vespid-tech/orbweaver/README.md

# orbweaver

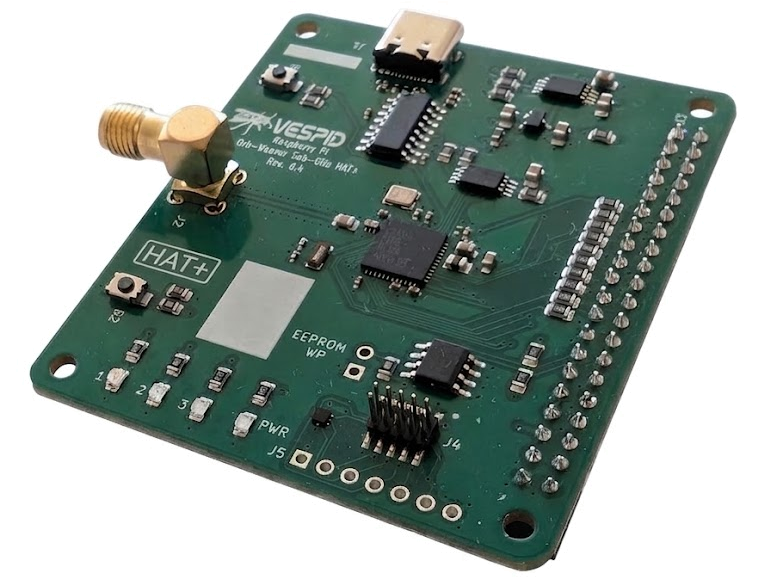
[picture p1: images/ow_pcb.png]


Orbweaver is a Sub-GHz HAT+ designed for the Raspberry Pi 5. When loaded with the Orbweaver firmware, it allows users to set-up peer-to-peer mesh networks between Raspberry Pi's, Desktop/Laptops, and Android mobile devices.

# Licensing & Trademarks

### Open Source Components
* **Hardware (`/hardware`)**: All hardware licensed under **CERN Open Hardware Licence Version 2 – Strongly Reciprocal** (`CERN-OHL-S-2.0`).
* **Firmware (`/firmware`)**: All firmware Licensed under the **GNU General Public License v3.0** (`GPL-3.0-only`).
* **Software (`/software`)**: All software Licensed under the **GNU General Public License v3.0** (`GPL-3.0-only`).
* **Documentation (`/documents`)**: All documentation (except the trademarks mentioned below) Licensed under the **Creative Commons Attribution-ShareAlike 4.0 International** (`CC BY-SA 4.0`).
* The full text of these licenses can be found in this repository in the hardware, software, and firmware folders they apply to.

### Non-open Source Components
* **Trademarks:** "Vespid," "Orbweaver," and associated logos are trademarks of Vespid.

# Questions, Info, Help

You can find out more about Vespid online at **[www.vespidtech.com](https://www.vespidtech.com)**.

# Disclaimer

Orbweaver is provided “as is,” without warranty of any kind express or implied. In no event shall Vespid or any Orbweaver developers or contributors be liable for any claim, damages, or other liability arising from its use. Orbweaver is intended for evaluation and development use only. It is not supplied as a finished product and is not certified for use in any product made for sale to the general public. The purchaser is responsible for ensuring that the final configuration (including but not limited to firmware configuration, transmission power, antenna selection, transmission frequency, etc.), complies with applicable regulatory requirements.
