vespid-tech/orbweaver/hardware/orbweaver_schematic.pdf

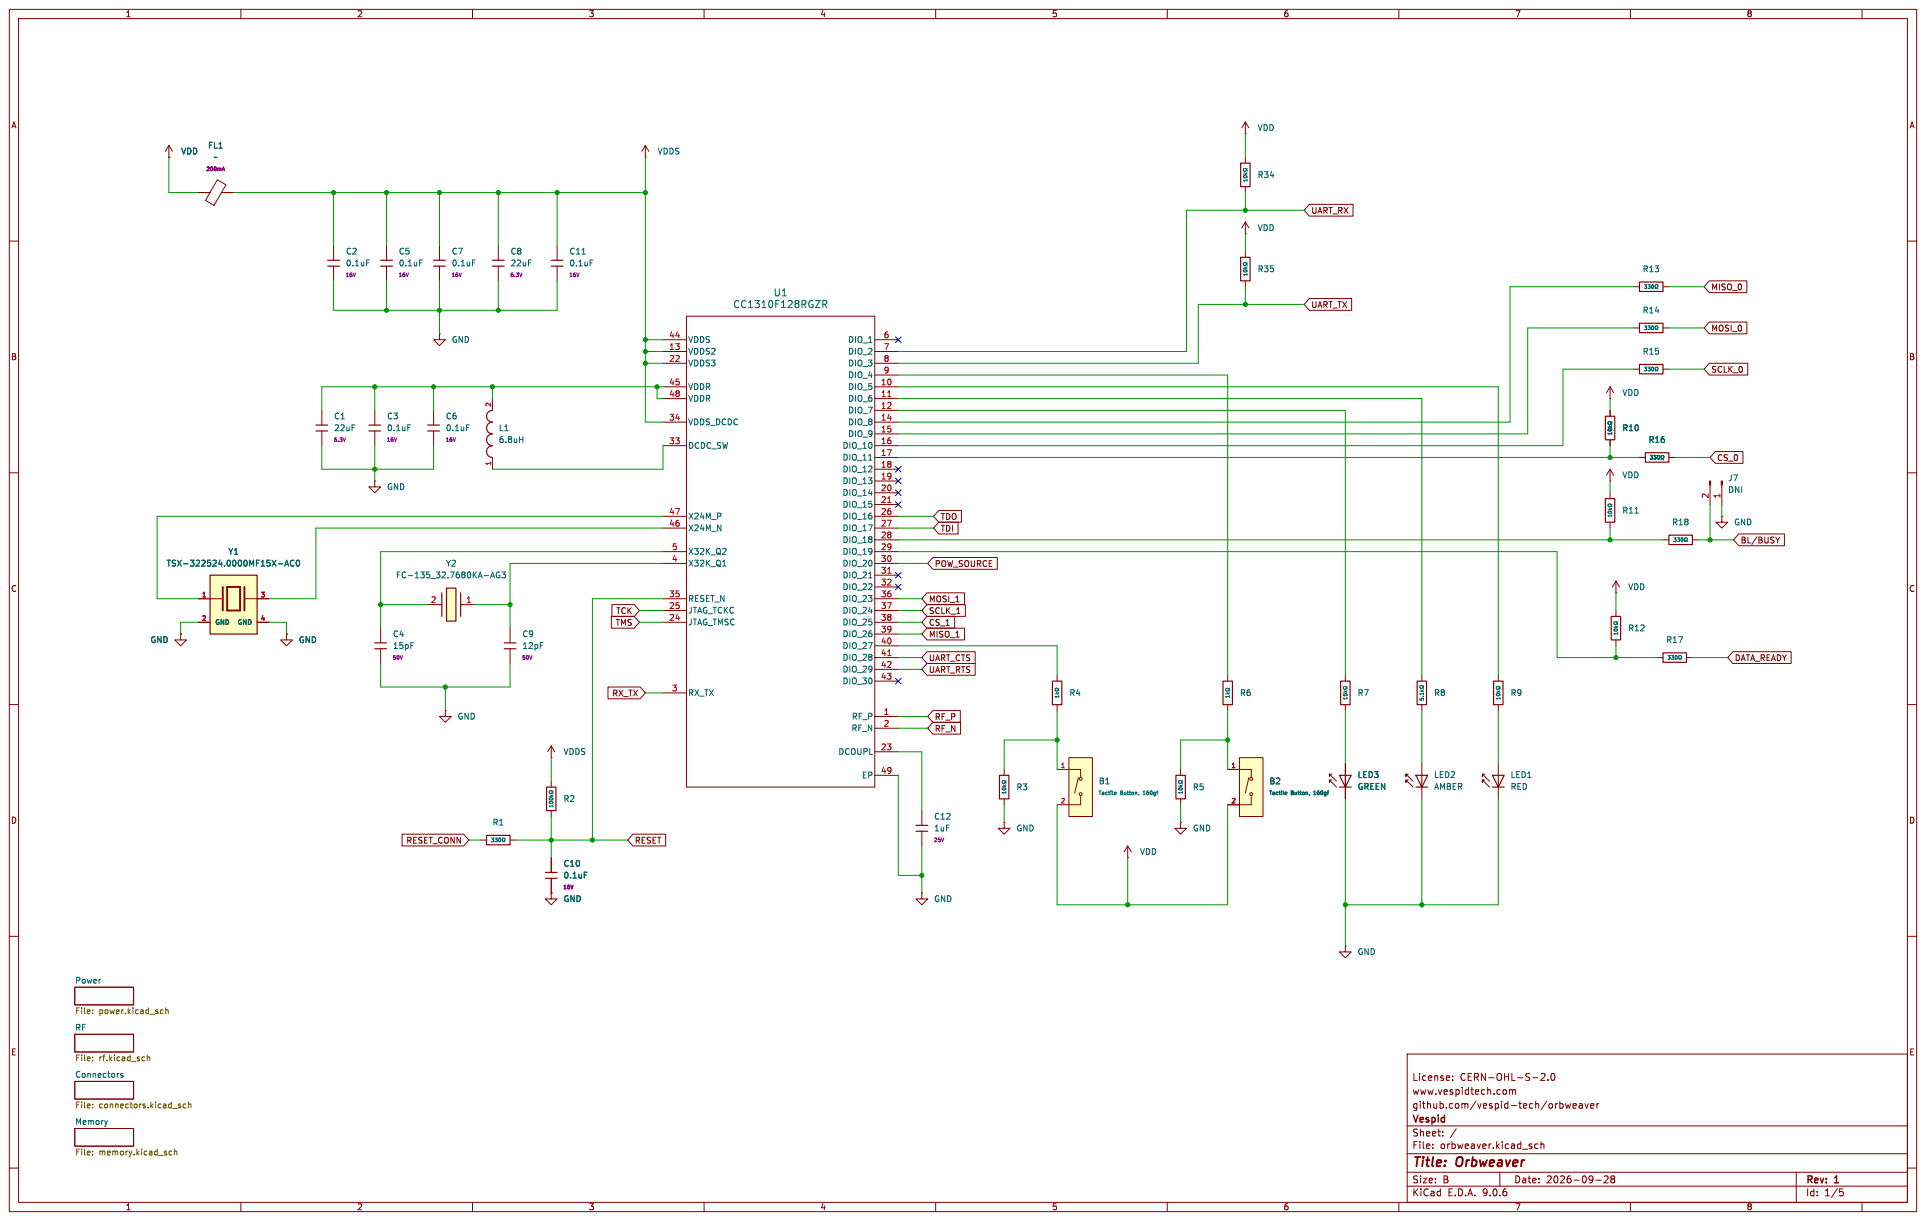
[picture p3: page 1]

File: rf.kicad_sch Power File: power.kicad_sch Connectors File: connectors.kicad_sch Memory File: memory.kicad_sch

License: CERN-OHL-S-2.0 RF

www.vespidtech.com
github.com/vespid-tech/orbweaver
Id: 1/5 Title: Orbweaver File: orbweaver.kicad_sch Sheet: / Vespid

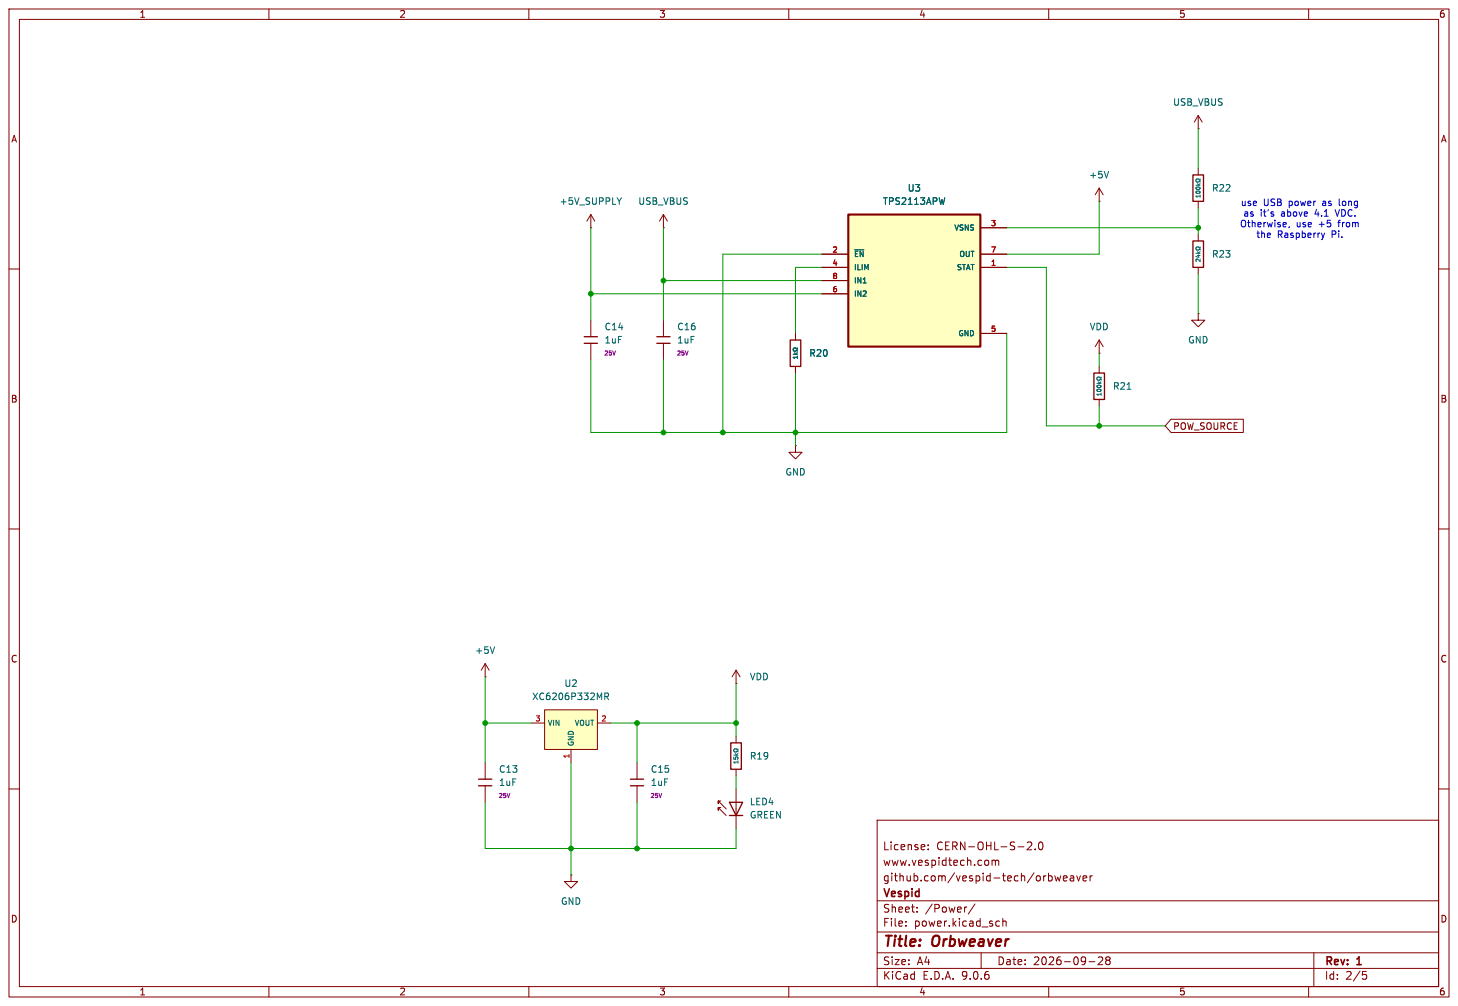
[picture p4: page 2]

use USB power as long
as it's above 4.1 VDC. Otherwise, use +5 from

www.vespidtech.com

github.com/vespid-tech/orbweaver

Id: 2/5 Title: Orbweaver File: power.kicad_sch Sheet: /Power/ Vespid

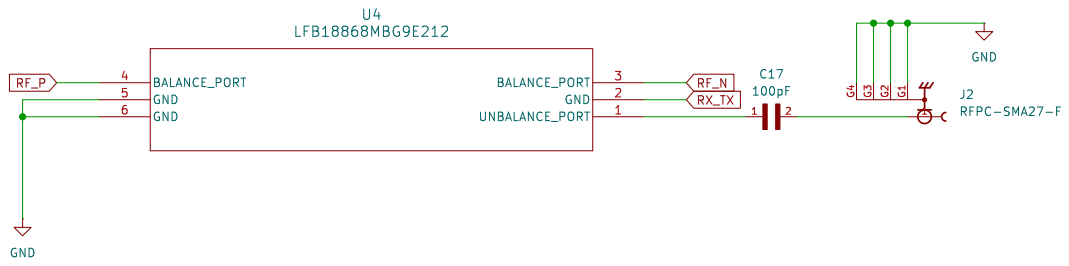
[picture p5: page 3]

www.vespidtech.com
github.com/vespid-tech/orbweaver
Id: 3/5 Title: Orbweaver File: rf.kicad_sch Sheet: /RF/ Vespid

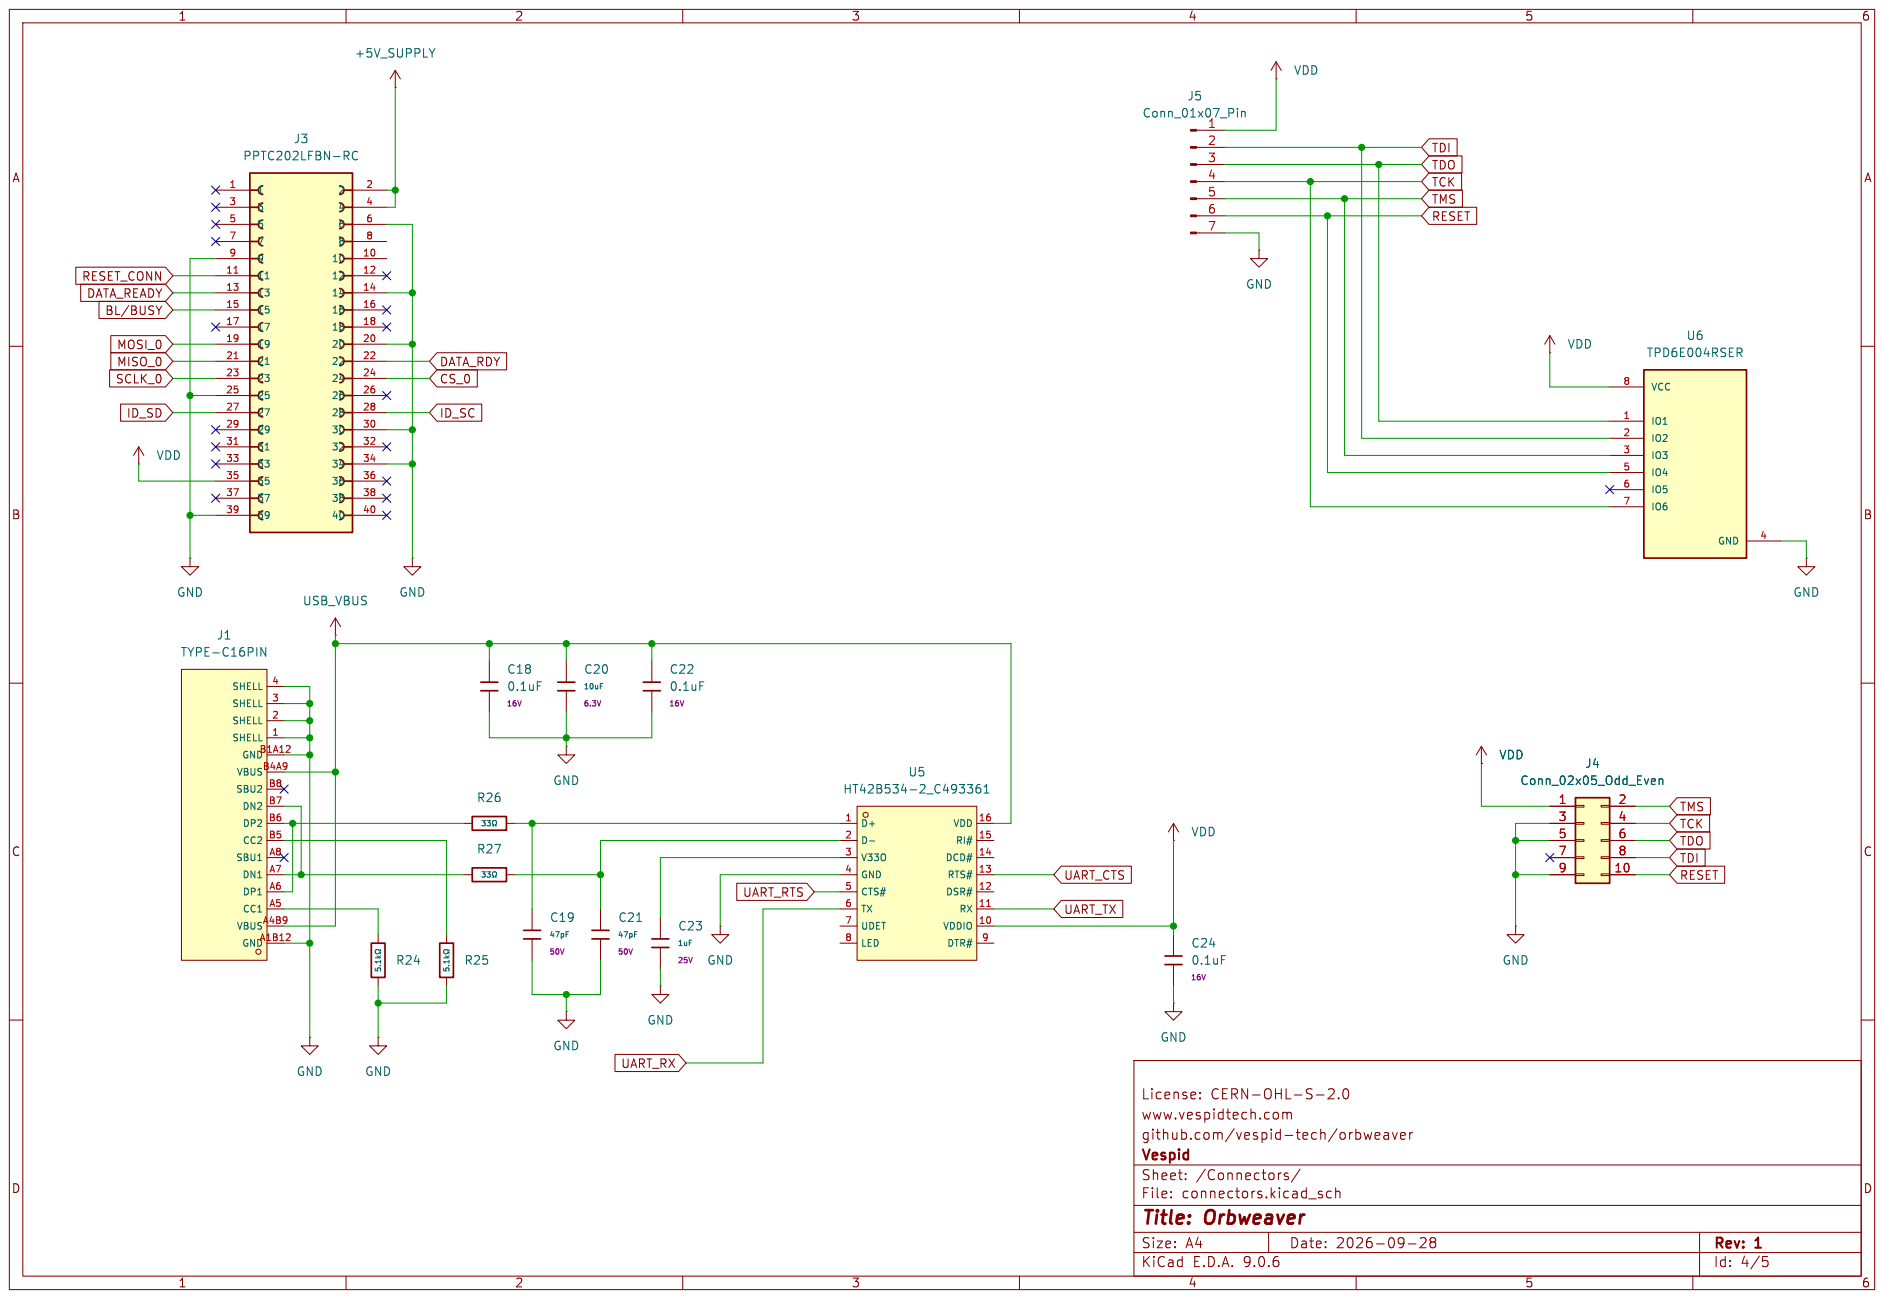
[picture p6: page 4]

www.vespidtech.com
github.com/vespid-tech/orbweaver
Id: 4/5 Title: Orbweaver File: connectors.kicad_sch Sheet: /Connectors/ Vespid

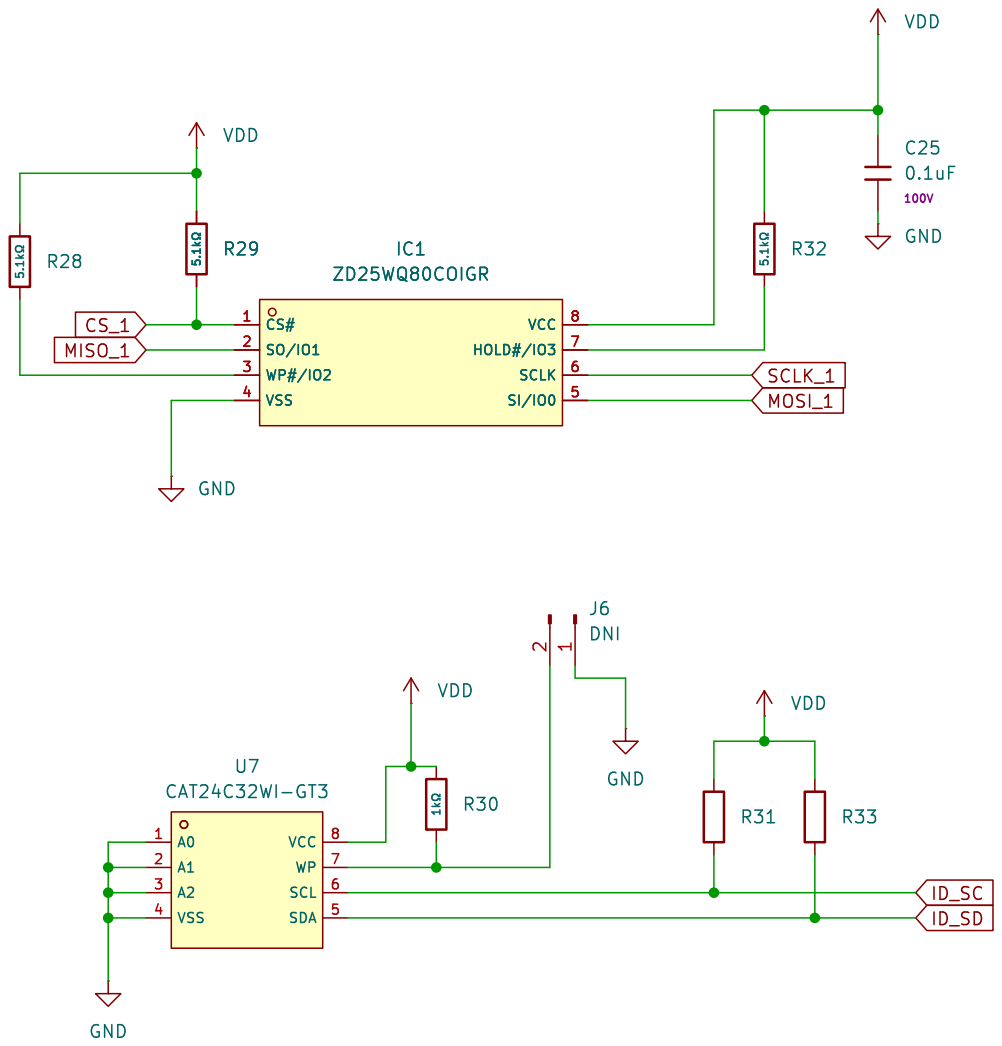
[picture p7: page 5]

www.vespidtech.com
github.com/vespid-tech/orbweaver
Vespid
Id: 5/5 Title: Orbweaver File: memory.kicad_sch Sheet: /Memory/
