vespid-tech/orbweaver/hardware/orbweaver.kicad_pcb

## KiCad design hardware/orbweaver.kicad_pcb (2026-10-01)

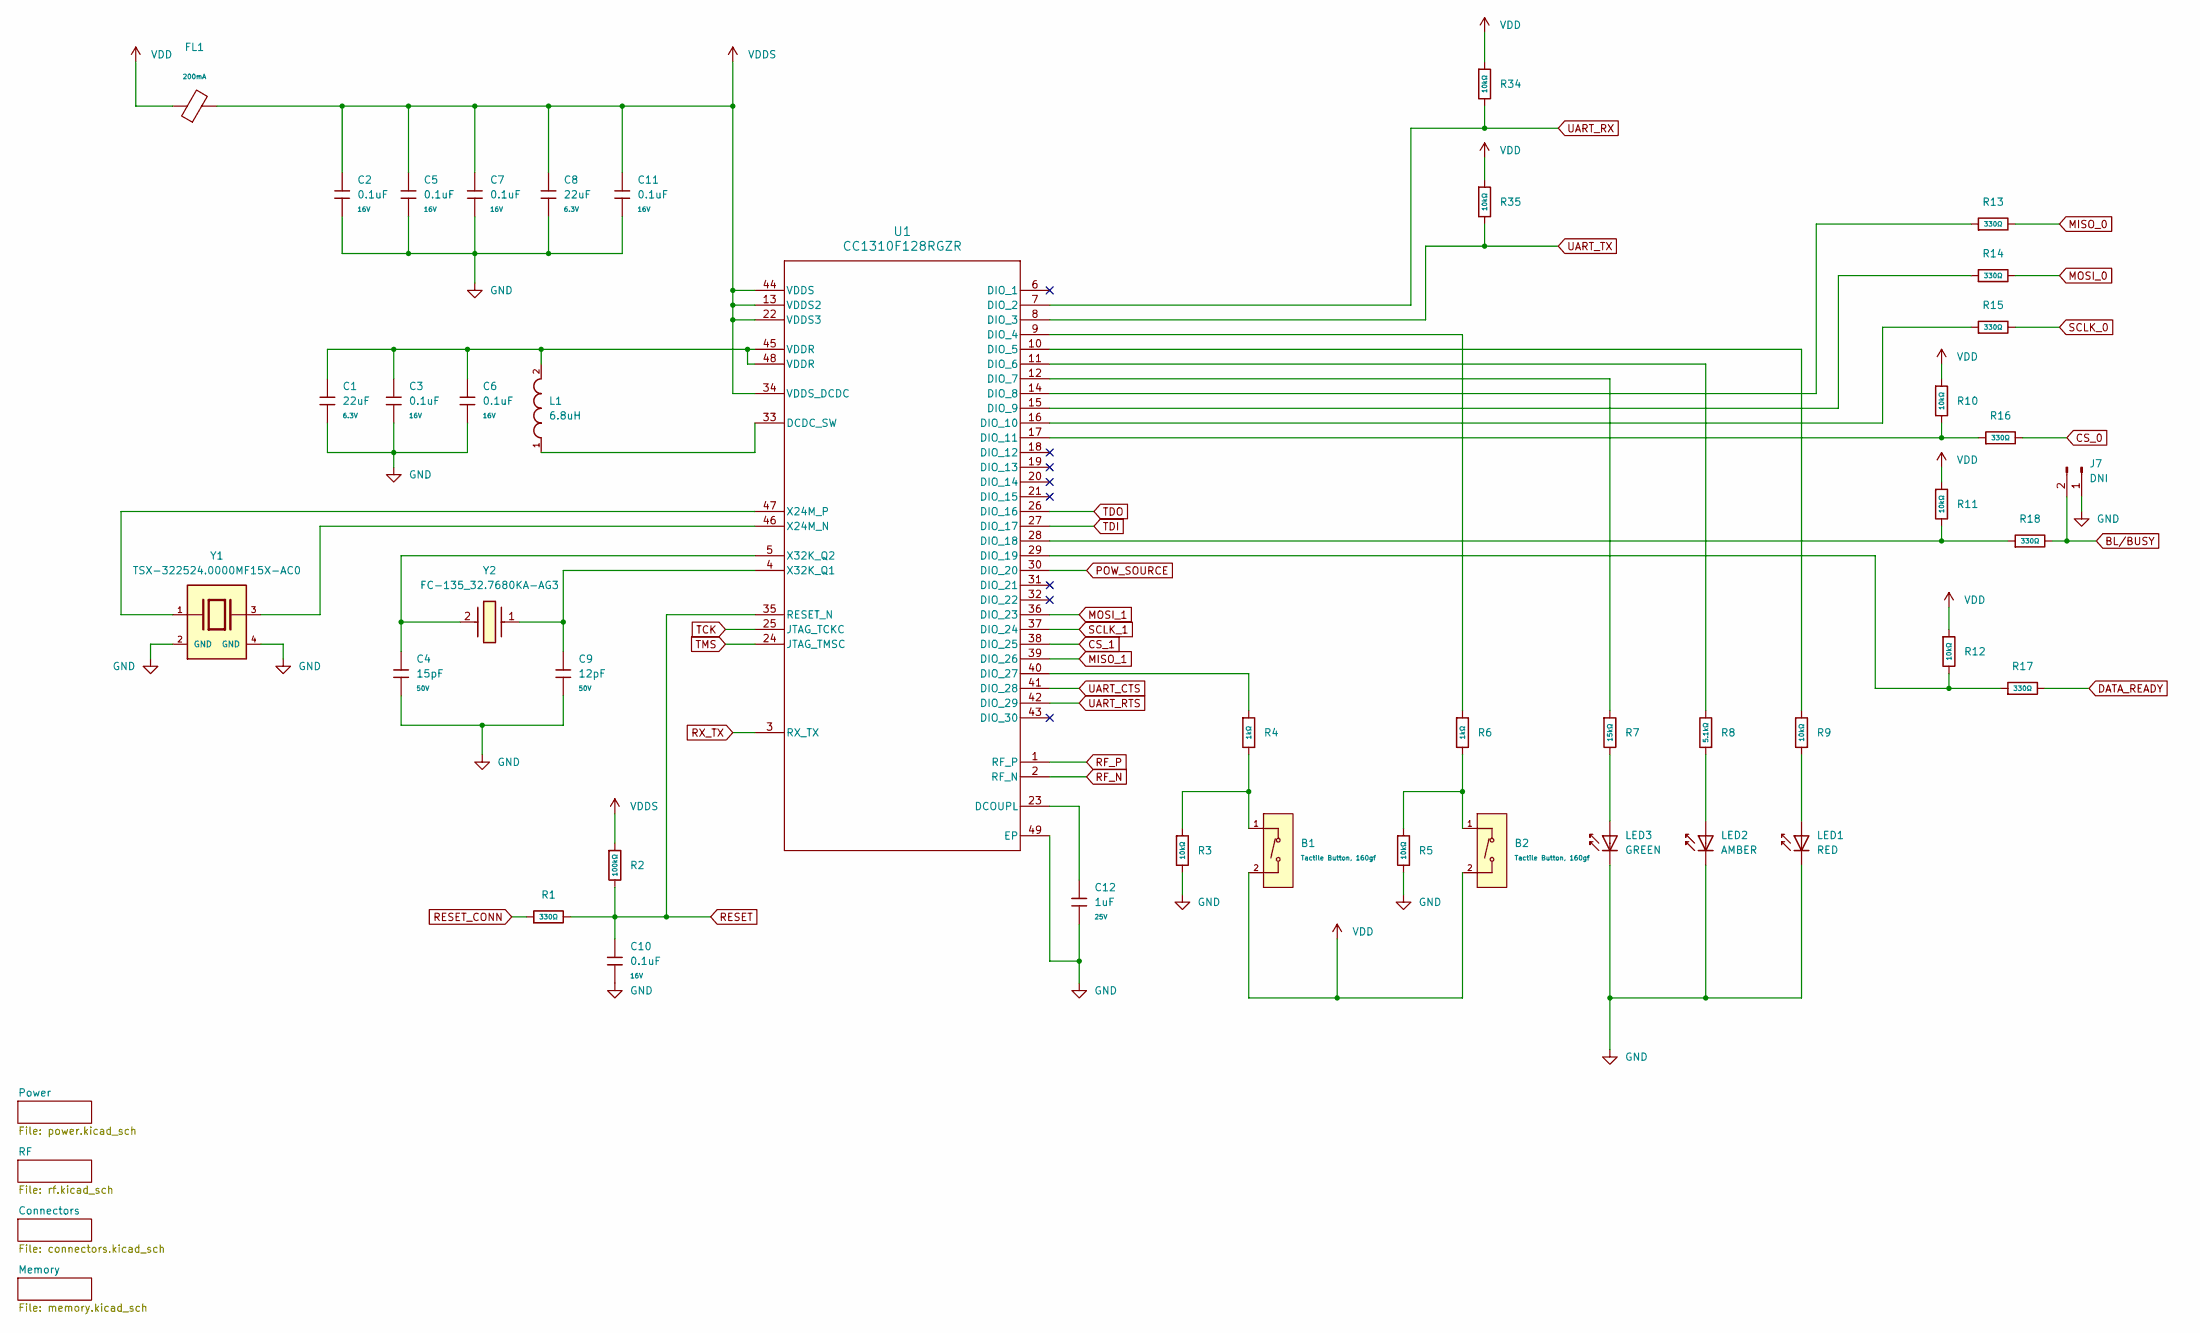
[picture p8: schematic orbweaver.kicad_sch]

Parts:
B1, B2: Tactile Button, 160gf; SW_TS-1088-AR02016; Voltage Rating (Dc) 12V; Part TS-1088-AR02016; LCSC C720477
C1, C8: 22uF; C_0603; Voltage Rated 6.3V; Tolerance ±20%; Part CL10A226MQ8NRNC; LCSC C59461
C2, C3, C5, C6, C7, C10, C11: 0.1uF; C_0402; Voltage Rated 16V; Tolerance ±10%; Part CL05B104KO5NNNC; LCSC C1525
C4: 15pF; C_0402; Voltage Rated 50V; Tolerance ±5%; Part 0402CG150J500NT; LCSC C1548
C9: 12pF; C_0402; Voltage Rated 50V; Tolerance ±5%; Part 0402CG120J500NT; LCSC C1547
C12: 1uF; C_0402; Voltage Rated 25V; Tolerance ±10%; Part CL05A105KA5NQNC; LCSC C52923
FL1: FB_0603; Current Rating 200mA; Tolerance ±25%; Part GZ1608D601TF; LCSC C1002
J7: DNI; PinHeader_1x02_P2.54mm_Vertical
L1: 6.8uH; INDC2012X105N; Mouser Part Number 810-MLZ2012N6R8LT000
LED1: RED; D_0805; Forward Voltage (VF) 1.6V~2.6V; Mouser Part Number 941-JE2835ARDN01AN
LED2: AMBER; D_0805; Mouser Part Number 941-JE2835ARDN01AN
LED3: GREEN; D_0805; Mouser Part Number 941-JE2835AGRN02AN
R1, R13, R14, R15, R16: 330Ω; R_0805; Overload Voltage (Max) 150V; Tolerance ±1%; Part 0805W8F1000T5E; LCSC C17408
R2: 100kΩ; R_0402; Overload Voltage (Max) 50V; Tolerance ±1%; Part 0402WGF1003TCE; DigiKey_Part_Number 541-CRCW0402100KFHEDPCT-ND
R3, R5, R9, R10, R11, R12, R34, R35: 10kΩ; R_0805; Overload Voltage (Max) 150V; Tolerance ±1%; Part 0805W8F1002T5E; LCSC C17414
R4, R6: 1kΩ; R_0805; Overload Voltage (Max) 150V; Tolerance ±1%; Part 0805W8F1001T5E; LCSC C17513
R7: 15kΩ; R_0805; Overload Voltage (Max) 150V; Tolerance ±1%; Part 0805W8F1502T5E; LCSC C17475
R8: 5.1kΩ; R_0805; Overload Voltage (Max) 150V; Tolerance ±1%; Part 0805W8F5101T5E; LCSC C27834
R17, R18: 330Ω; R_0805; Overload Voltage (Max) 150V; Tolerance ±1%; Part 0805W8F3300T5E; LCSC C17630
U1: CC1310F128RGZR; Texas_RGZ0048A_VQFN-48-1EP_7x7mm_P0.5mm_EP5.15x5.15mm
Y1: TSX-322524.0000MF15X-AC0; XTAL_TSX-3225_24.0000MF15X-AC0; PARTREV N/A
Y2: FC-135_32.7680KA-AG3; FC135327680KAAG3; Mouser Part Number 732-FC135-32.76KAAG3

Connections:
BL/BUSY: J7.2, R18.2; also elsewhere on the board
CS_0: R16.2; also elsewhere on the board
CS_1: U1.38 (DIO_25); also elsewhere on the board
DATA_READY: R17.2; also elsewhere on the board
GND: C1.1, C2.1, C3.1, C4.1, C5.1, C6.1, C7.1, C8.1, C9.1, C10.1, C11.1, C12.1, J7.1, LED1.1, LED2.1, LED3.1, R3.2, R5.2, U1.49 (EP), Y1.2 (GND), Y1.4 (GND); also elsewhere on the board
MISO_0: R13.2; also elsewhere on the board
MISO_1: U1.39 (DIO_26); also elsewhere on the board
MOSI_0: R14.2; also elsewhere on the board
MOSI_1: U1.36 (DIO_23); also elsewhere on the board
unnamed: B1.1 (A), R3.1, R4.2
unnamed: B2.1 (A), R5.1, R6.2
unnamed: C1.2, C3.2, C6.2, L1.2, U1.45 (VDDR), U1.48 (VDDR)
unnamed: LED1.2, R9.1
unnamed: LED2.2, R8.1
unnamed: LED3.2, R7.2
unnamed: L1.1, U1.33 (DCDC_SW)
unnamed: C12.2, U1.23 (DCOUPL)
unnamed: R6.1, U1.9 (DIO_4)
unnamed: R9.2, U1.10 (DIO_5)
unnamed: R8.2, U1.11 (DIO_6)
unnamed: R7.1, U1.12 (DIO_7)
unnamed: R13.1, U1.14 (DIO_8)
unnamed: R14.1, U1.15 (DIO_9)
unnamed: R15.1, U1.16 (DIO_10)
unnamed: R10.2, R16.1, U1.17 (DIO_11)
unnamed: R11.2, R18.1, U1.28 (DIO_18)
unnamed: R12.2, R17.1, U1.29 (DIO_19)
unnamed: R4.1, U1.40 (DIO_27)
unnamed: U1.46 (X24M_N), Y1.3
unnamed: U1.47 (X24M_P), Y1.1
unnamed: C9.2, U1.4 (X32K_Q1), Y2.1
unnamed: C4.2, U1.5 (X32K_Q2), Y2.2 (CRYSTAL_2)
POW_SOURCE: U1.30 (DIO_20); also elsewhere on the board
RESET: C10.2, R1.2, R2.2, U1.35 (RESET_N); also elsewhere on the board
RESET_CONN: R1.1; also elsewhere on the board
RF_N: U1.2 (RF_N); also elsewhere on the board
RF_P: U1.1 (RF_P); also elsewhere on the board
RX_TX: U1.3 (RX_TX); also elsewhere on the board
SCLK_0: R15.2; also elsewhere on the board
SCLK_1: U1.37 (DIO_24); also elsewhere on the board
TCK: U1.25 (JTAG_TCKC); also elsewhere on the board
TDI: U1.27 (DIO_17); also elsewhere on the board
TDO: U1.26 (DIO_16); also elsewhere on the board
TMS: U1.24 (JTAG_TMSC); also elsewhere on the board
UART_CTS: U1.41 (DIO_28); also elsewhere on the board
UART_RTS: U1.42 (DIO_29); also elsewhere on the board
UART_RX: R34.2, U1.7 (DIO_2); also elsewhere on the board
UART_TX: R35.2, U1.8 (DIO_3); also elsewhere on the board
VDD: B1.2 (B), B2.2 (B), FL1.1, R10.1, R11.1, R12.1, R34.1, R35.1; also elsewhere on the board
VDDS: C2.2, C5.2, C7.2, C8.2, C11.2, FL1.2, R2.1, U1.13 (VDDS2), U1.22 (VDDS3), U1.34 (VDDS_DCDC), U1.44 (VDDS)

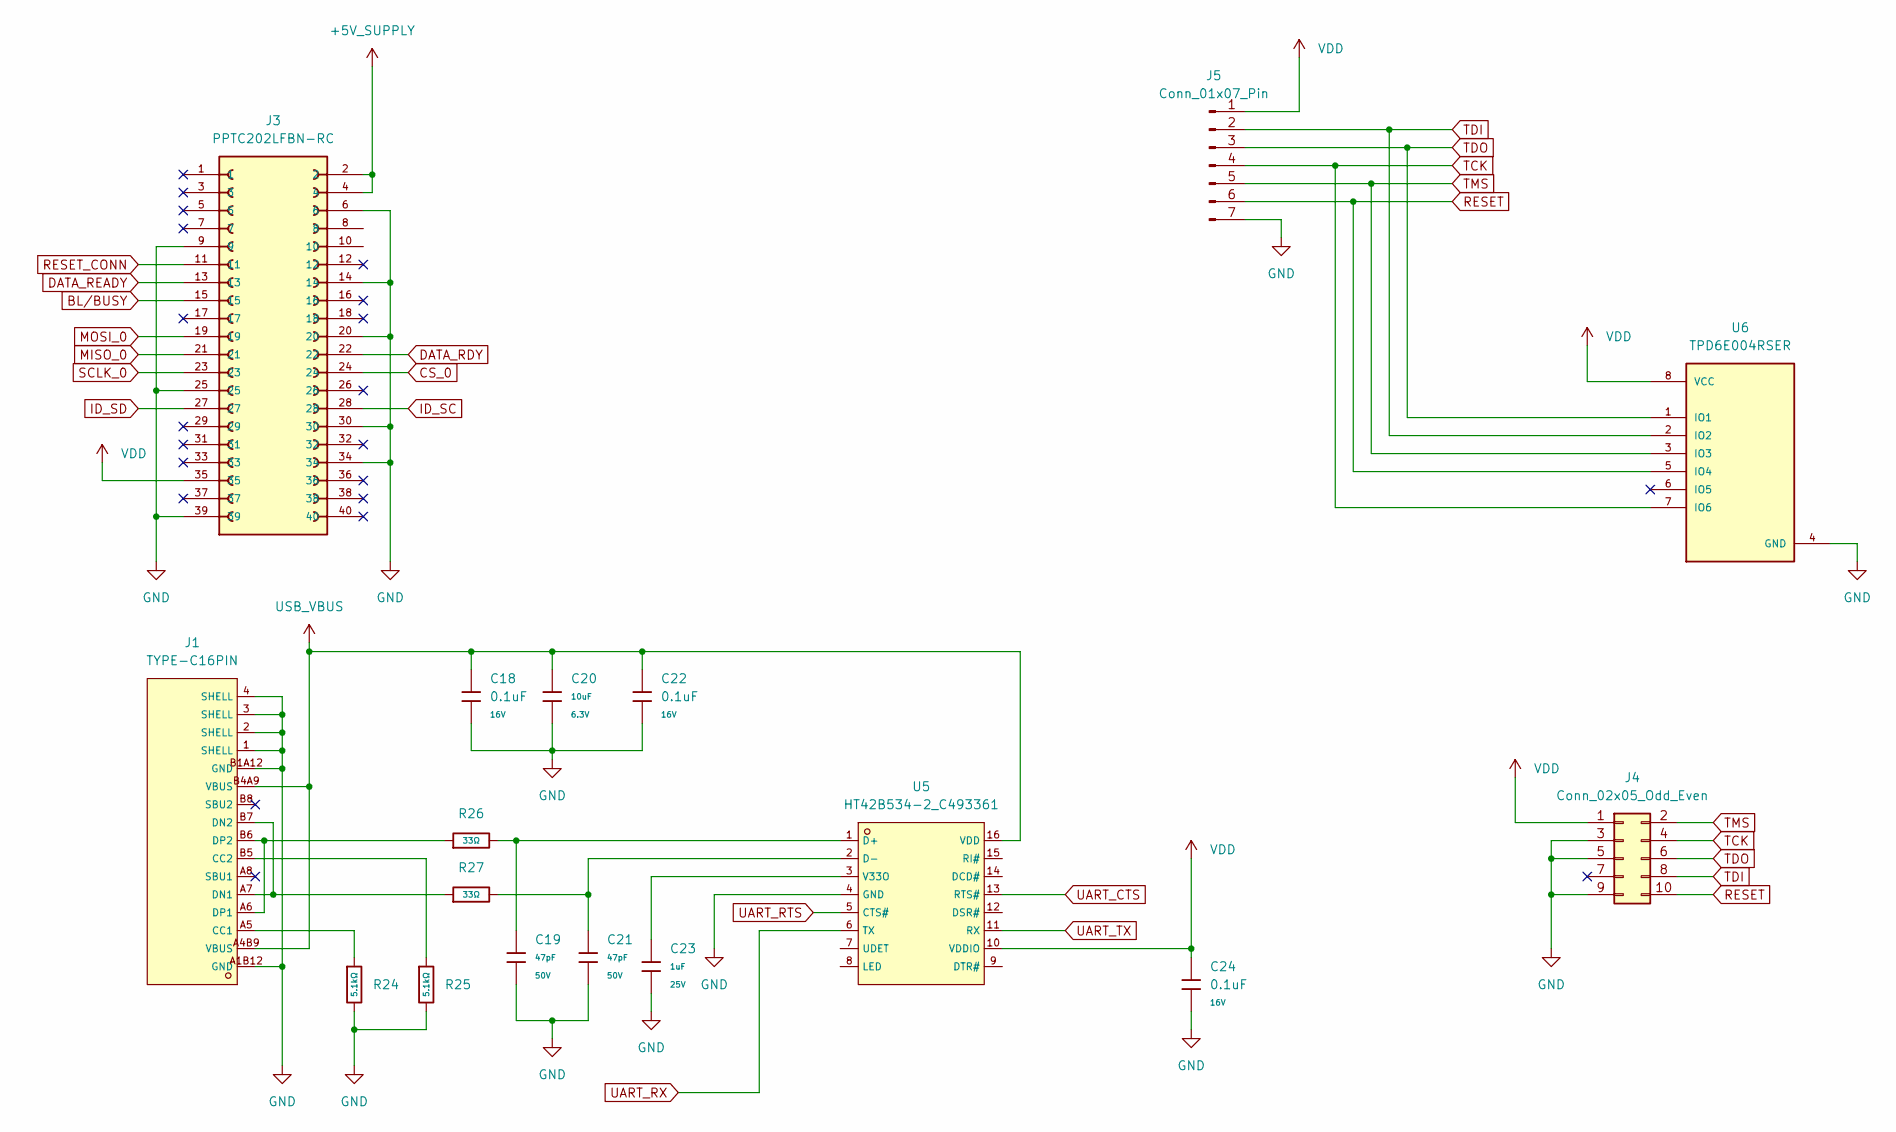
[picture p9: schematic connectors.kicad_sch, Orbweaver]

Parts:
C18, C22, C24: 0.1uF; C_0402; Voltage Rated 16V; Tolerance ±10%; Part CL05B104KO5NNNC; LCSC C1525
C19, C21: 47pF; C_0402; Voltage Rated 50V; Tolerance ±5%; Part 0402CG470J500NT; LCSC C1567
C20: 10uF; C_0402; Voltage Rated 6.3V; Tolerance ±20%; Part CL05A106MQ5NUNC; LCSC C15525
C23: 1uF; C_0402; Voltage Rated 25V; Tolerance ±10%; Part CL05A105KA5NQNC; LCSC C52923
J1: TYPE-C16PIN; USB-C-SMD_TYPE-C16PIN; LCSC C393939
J3: PPTC202LFBN-RC; SULLINS_PPTC202LFBN-RC; PARTREV L
J4: Conn_02x05_Odd_Even; PinHeader_2x05_P1.27mm_Vertical_SMD
J5: Conn_01x07_Pin; PinHeader_1x07_P2.54mm_Vertical
R24, R25: 5.1kΩ; R_0402; Overload Voltage (Max) 50V; Tolerance ±1%; Part 0402WGF5101TCE; LCSC C25905
R26, R27: 33Ω; R_0402; Overload Voltage (Max) 50V; Tolerance ±1%; Part 0402WGF330JTCE; LCSC C25105
U5: HT42B534-2_C493361; NSOP-16_L9.9-W3.9-P1.27-LS6.0-BL; LCSC C493361
U6: TPD6E004RSER; IC_TPD6E004RSER; PARTREV 4220323/B 03/2018

Connections:
+5V_SUPPLY: J3.2, J3.4; also elsewhere on the board
BL/BUSY: J3.15; also elsewhere on the board
CS_0: J3.24; also elsewhere on the board
DATA_RDY: J3.22
DATA_READY: J3.13; also elsewhere on the board
GND: C18.1, C19.2, C20.2, C21.2, C22.1, C23.2, C24.1, J1.1 (SHELL), J1.2 (SHELL), J1.3 (SHELL), J1.4 (SHELL), J1.A1B12 (GND), J1.B1A12 (GND), J3.6, J3.9, J3.14, J3.20, J3.25, J3.30, J3.34, J3.39, J4.3, J4.5, J4.9, J5.7, R24.2, R25.2, U5.4 (GND), U6.4 (GND); also elsewhere on the board
ID_SC: J3.28; also elsewhere on the board
ID_SD: J3.27; also elsewhere on the board
MISO_0: J3.21; also elsewhere on the board
MOSI_0: J3.19; also elsewhere on the board
unnamed: J1.A5 (CC1), R24.1
unnamed: J1.B5 (CC2), R25.1
unnamed: J1.A7 (DN1), J1.B7 (DN2), R27.1
unnamed: J1.A6 (DP1), J1.B6 (DP2), R26.1
unnamed: C19.1, R26.2, U5.1 (D+)
unnamed: C21.1, R27.2, U5.2 (D-)
unnamed: C23.1, U5.3 (V33O)
RESET: J4.10, J5.6, U6.5 (IO4); also elsewhere on the board
RESET_CONN: J3.11; also elsewhere on the board
SCLK_0: J3.23; also elsewhere on the board
TCK: J4.4, J5.4, U6.7 (IO6); also elsewhere on the board
TDI: J4.8, J5.2, U6.2 (IO2); also elsewhere on the board
TDO: J4.6, J5.3, U6.1 (IO1); also elsewhere on the board
TMS: J4.2, J5.5, U6.3 (IO3); also elsewhere on the board
UART_CTS: U5.13 (RTS#); also elsewhere on the board
UART_RTS: U5.5 (CTS#); also elsewhere on the board
UART_RX: U5.6 (TX); also elsewhere on the board
UART_TX: U5.11 (RX); also elsewhere on the board
USB_VBUS: C18.2, C20.1, C22.2, J1.A4B9 (VBUS), J1.B4A9 (VBUS), U5.16 (VDD); also elsewhere on the board
VDD: C24.2, J3.35, J4.1, J5.1, U5.10 (VDDIO), U6.8 (VCC); also elsewhere on the board

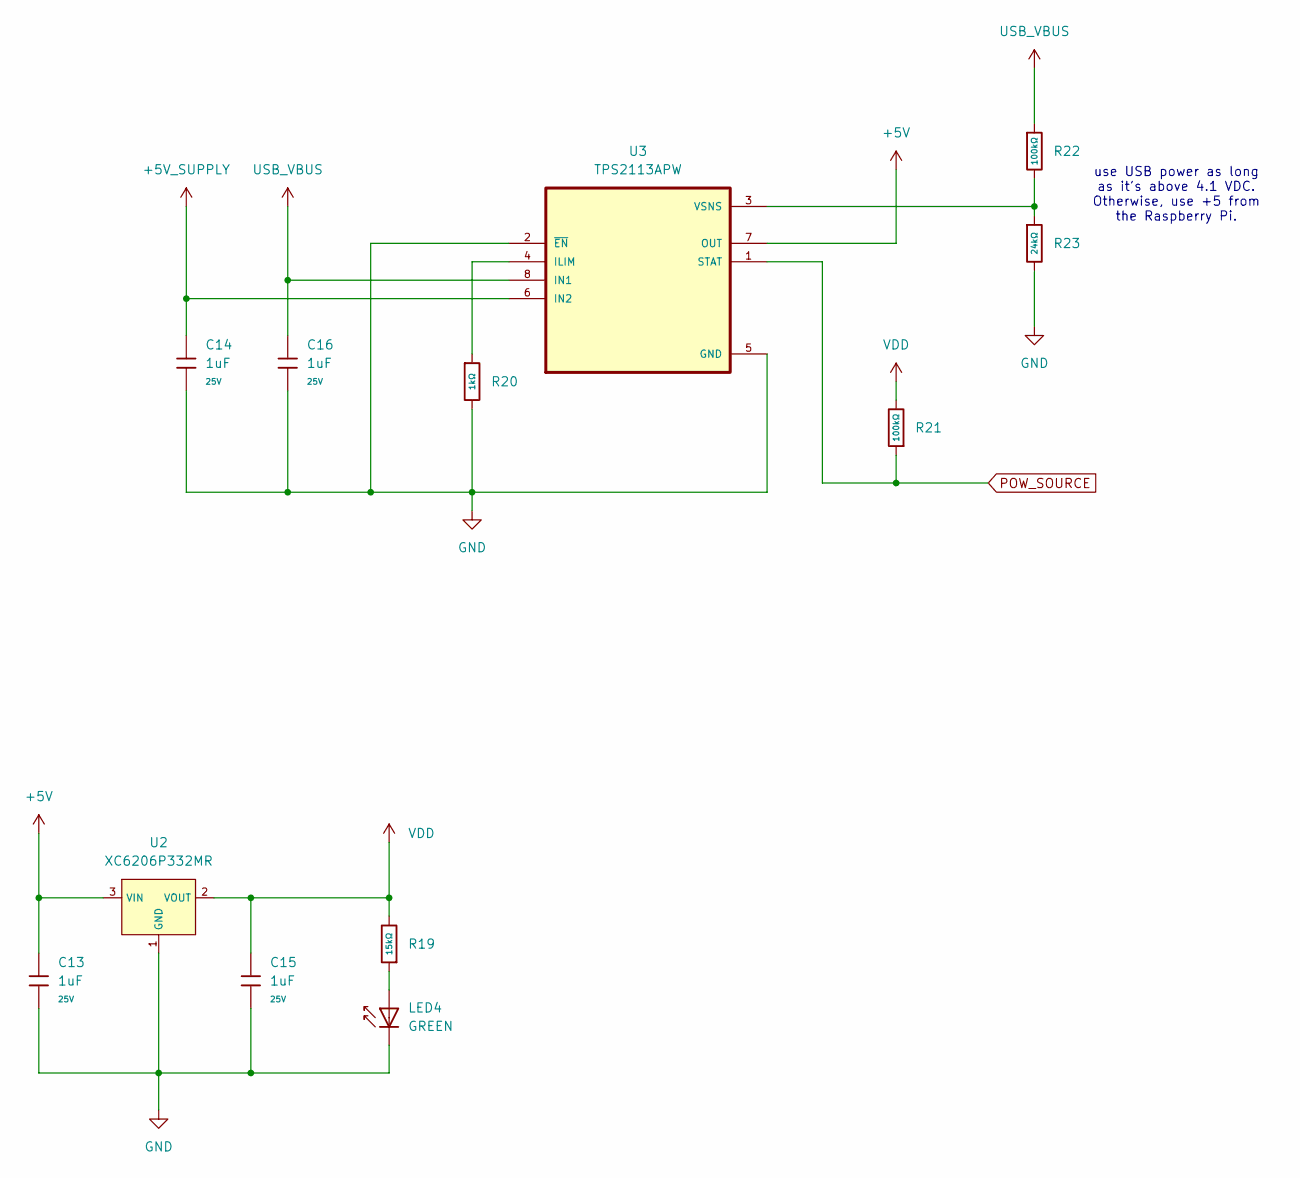
[picture p10: schematic power.kicad_sch, Orbweaver]

Parts:
C13, C14, C15, C16: 1uF; C_0805; Voltage Rated 25V; Tolerance ±10%; Part CL05A105KA5NQNC; LCSC C52923
LED4: GREEN; D_0805; Forward Voltage (VF) 1.6V~2.6V; Mouser Part Number 941-JE2835ARDN01AN
R19: 15kΩ; R_0805; Overload Voltage (Max) 150V; Tolerance ±1%; Part 0805W8F1502T5E; LCSC C17475
R20: 1kΩ; R_0805; Overload Voltage (Max) 150V; Tolerance ±1%; Part 0805W8F1001T5E; LCSC C17513
R21, R22: 100kΩ; R_0805; Overload Voltage (Max) 150V; Tolerance ±1%; Part 0805W8F1003T5E; DigiKey_Part_Number 541-CRCW0402100KFHEDPCT-ND
R23: 24kΩ; R_0805; Overload Voltage (Max) 150V; Tolerance ±1%; Part 0805W8F2402T5E; LCSC C17575
U2: XC6206P332MR; SOT-23-3_L2.9-W1.6-P1.90-LS2.8-BR; Output Voltage 3.3V; Dropout Voltage 680mV@(100mA); Part XC6206P332MR-G; LCSC C5446
U3: TPS2113APW; SOP65P640X120-8N

Connections:
+5V: C13.2, U2.3 (VIN), U3.7 (OUT)
+5V_SUPPLY: C14.2, U3.6 (IN2); also elsewhere on the board
GND: C13.1, C14.1, C15.1, C16.1, LED4.1, R20.2, R23.2, U2.1 (GND), U3.2 (~EN), U3.5 (GND); also elsewhere on the board
unnamed: LED4.2, R19.1
unnamed: R20.1, U3.4 (ILIM)
unnamed: R22.2, R23.1, U3.3 (VSNS)
POW_SOURCE: R21.1, U3.1 (STAT); also elsewhere on the board
USB_VBUS: C16.2, R22.1, U3.8 (IN1); also elsewhere on the board
VDD: C15.2, R19.2, R21.2, U2.2 (VOUT); also elsewhere on the board

Notes on the sheet:
use USB power as long as it's above 4.1 VDC. Otherwise, use +5 from the Raspberry Pi.

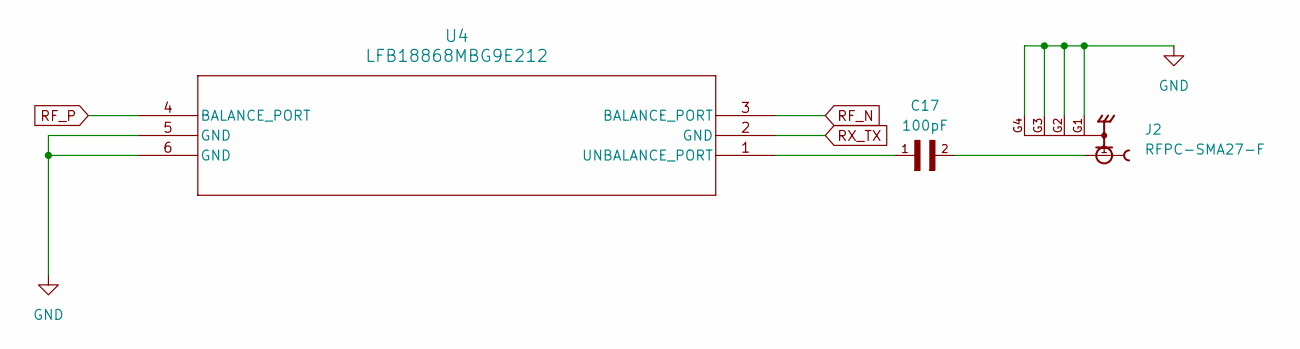
[picture p11: schematic rf.kicad_sch, Orbweaver]

Parts:
C17: 100pF; C_0805
J2: RFPC-SMA27-F; GRADCONN_RFPC-SMA27-F; PARTREV 1.0
U4: LFB18868MBG9E212; LFB18868MBG9E212_MUR

Connections:
GND: J2.G1, J2.G2, J2.G3, J2.G4, U4.5 (GND), U4.6 (GND); also elsewhere on the board
unnamed: C17.2, J2.1
unnamed: C17.1, U4.1 (UNBALANCE_PORT)
RF_N: U4.3 (BALANCE_PORT); also elsewhere on the board
RF_P: U4.4 (BALANCE_PORT); also elsewhere on the board
RX_TX: U4.2 (GND); also elsewhere on the board

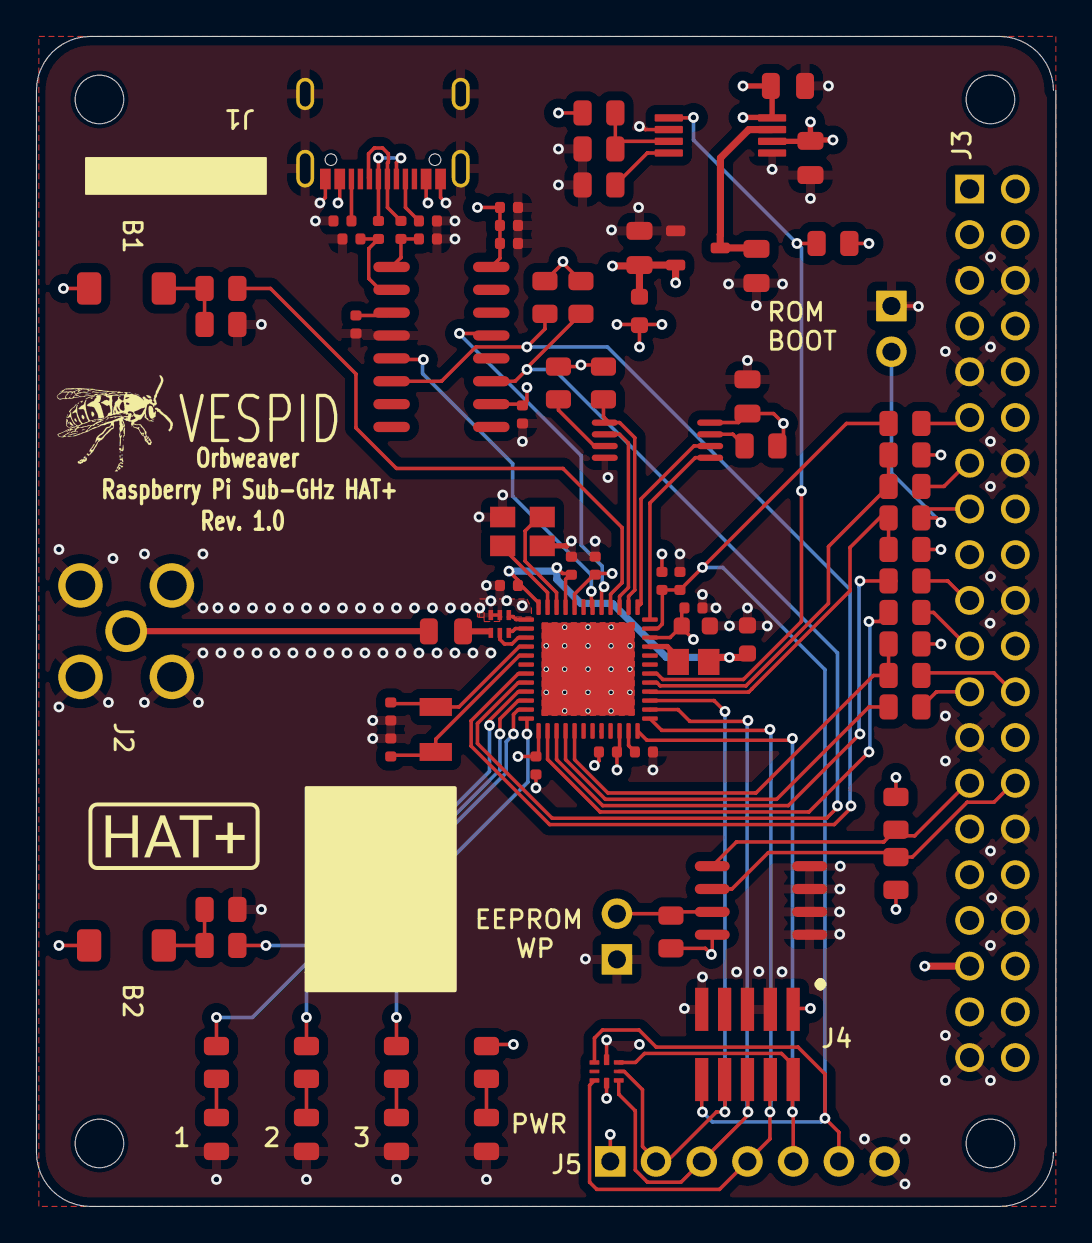
[picture p12: board orbweaver.kicad_pcb from above]

Board: 4 copper layers, 56.6 x 65.0 mm, 85 parts (1 on the bottom side), 70 nets.

Other parts of the board:
C25: 0.1uF; C_0805
IC1: ZD25WQ80COIGR; TSSOP-8_L4.4-W3.0-P0.65-LS6.4-BL
J6: DNI; PinHeader_1x02_P2.54mm_Vertical
R28, R29, R32: 5.1kΩ; R_0805
R30: 1kΩ; R_0805
R31, R33: 3.9kΩ; R_0805
U7: CAT24C32WI-GT3; SOIC-8_L5.0-W4.0-P1.27-LS6.0-BL

Their connections:
CS_1: IC1.1 (CS#), R29.2; also elsewhere on the board
GND: C25.1, IC1.4 (VSS), J6.1, U7.1 (A0), U7.2 (A1), U7.3 (A2), U7.4 (VSS); also elsewhere on the board
ID_SC: R31.2, U7.6 (SCL); also elsewhere on the board
ID_SD: R33.2, U7.5 (SDA); also elsewhere on the board
MISO_1: IC1.2 (SO/IO1); also elsewhere on the board
MOSI_1: IC1.5 (SI/IO0); also elsewhere on the board
unnamed: IC1.7 (HOLD#/IO3), R32.2
unnamed: IC1.3 (WP#/IO2), R28.2
unnamed: J6.2, R30.2, U7.7 (WP)
SCLK_1: IC1.6 (SCLK); also elsewhere on the board
VDD: C25.2, IC1.8 (VCC), R28.1, R29.1, R30.1, R31.1, R32.1, R33.1, U7.8 (VCC); also elsewhere on the board
