vespid-tech/orbweaver/(commit log)

2026-09-27 Adding hardware to public repo.
    [connectors.kicad_sch, mcu.kicad_sch, orbweaver.kicad_pcb, power.kicad_sch, rf.kicad_sch]
2026-09-28 Added schematic title block info, and pdf version of schematic.
    [connectors.kicad_sch, mcu.kicad_sch, power.kicad_sch, rf.kicad_sch]
2026-09-30 Added pull-ups to UART RX and TX. Adding load_via_rombl_usb.py.
2026-10-01 Fixed firmware python scripts. Updated public schematics.
    [orbweaver.kicad_pcb, orbweaver.kicad_sch]
